kobusm/gecko-controller/Print Schematic.pdf

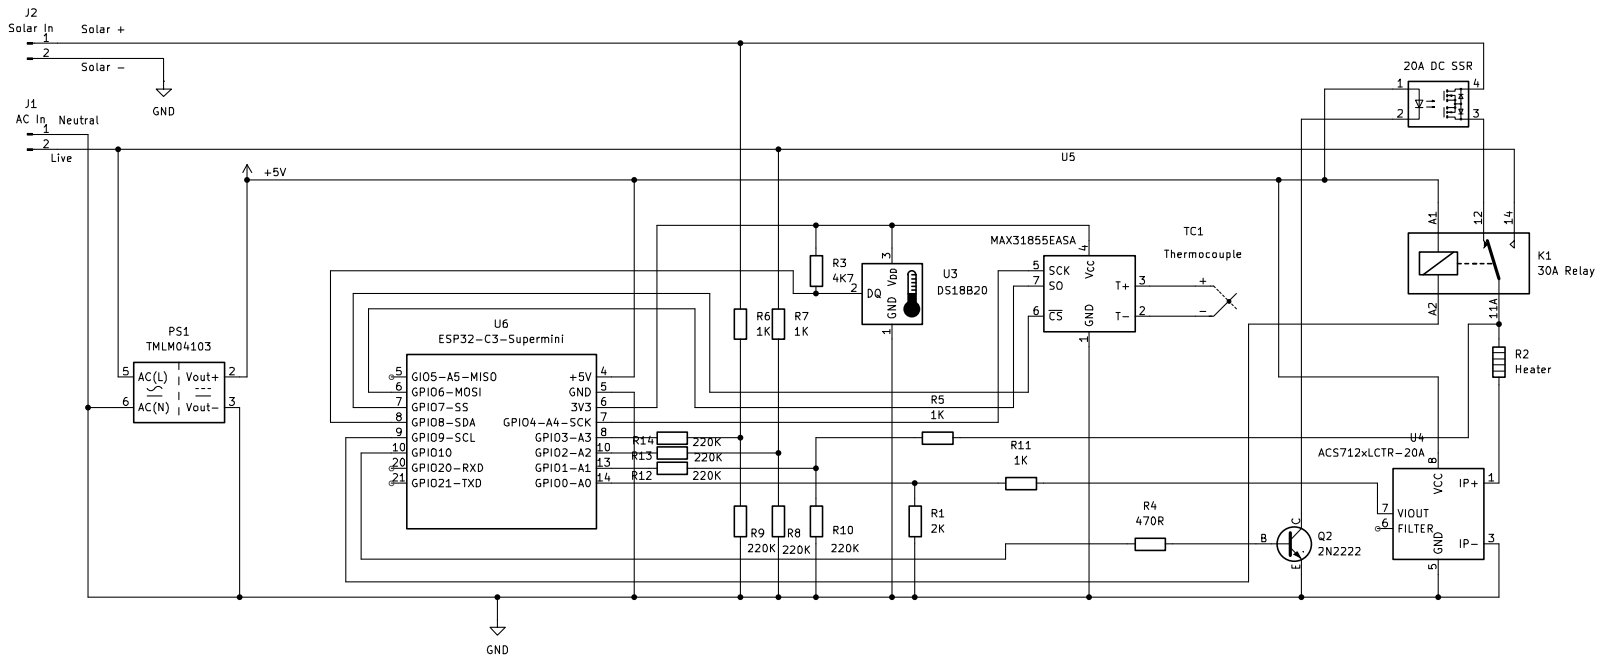
[picture p1: page 1]
