kobusm/gecko-controller/BetterGecko.pdf

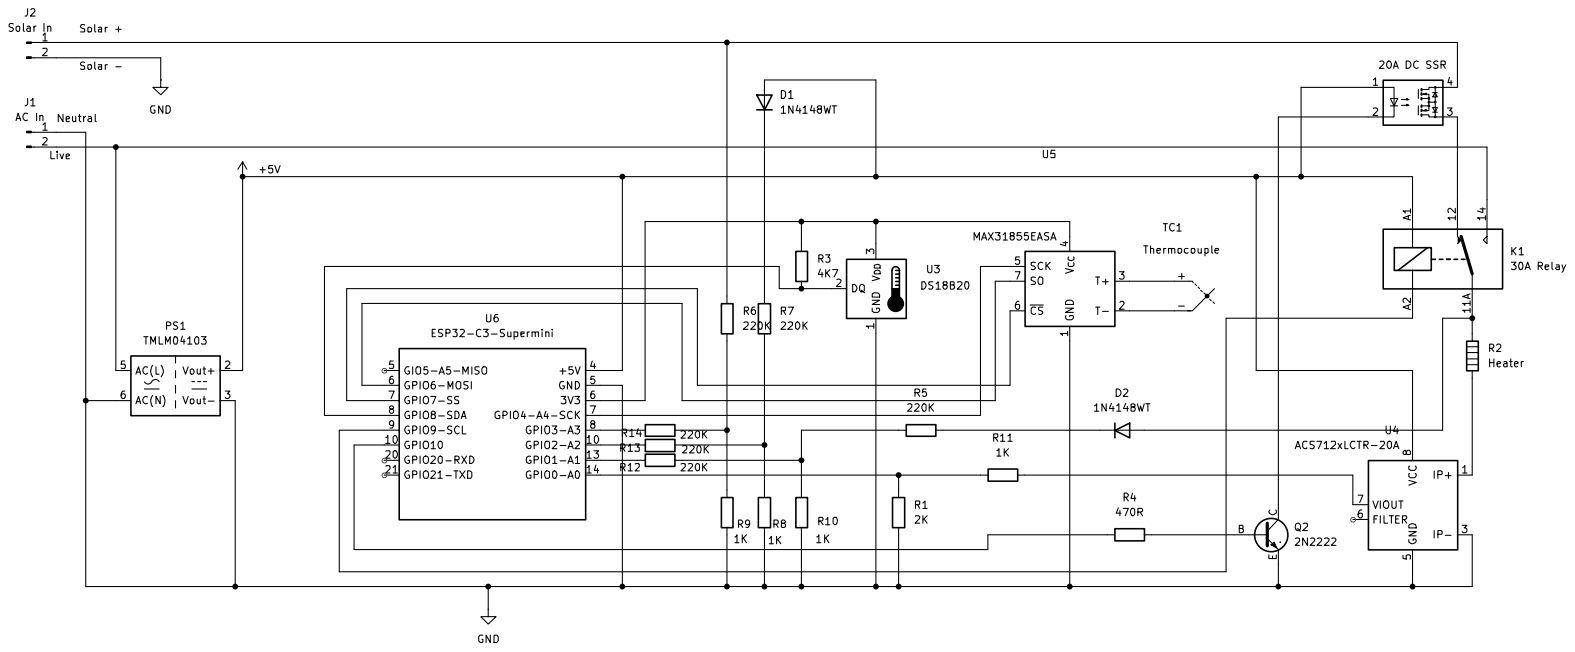
[picture p2: page 1]
