kobusm/gecko-controller/BetterGecko.kicad_sch

## KiCad design BetterGecko.kicad_sch (2026-05-28)

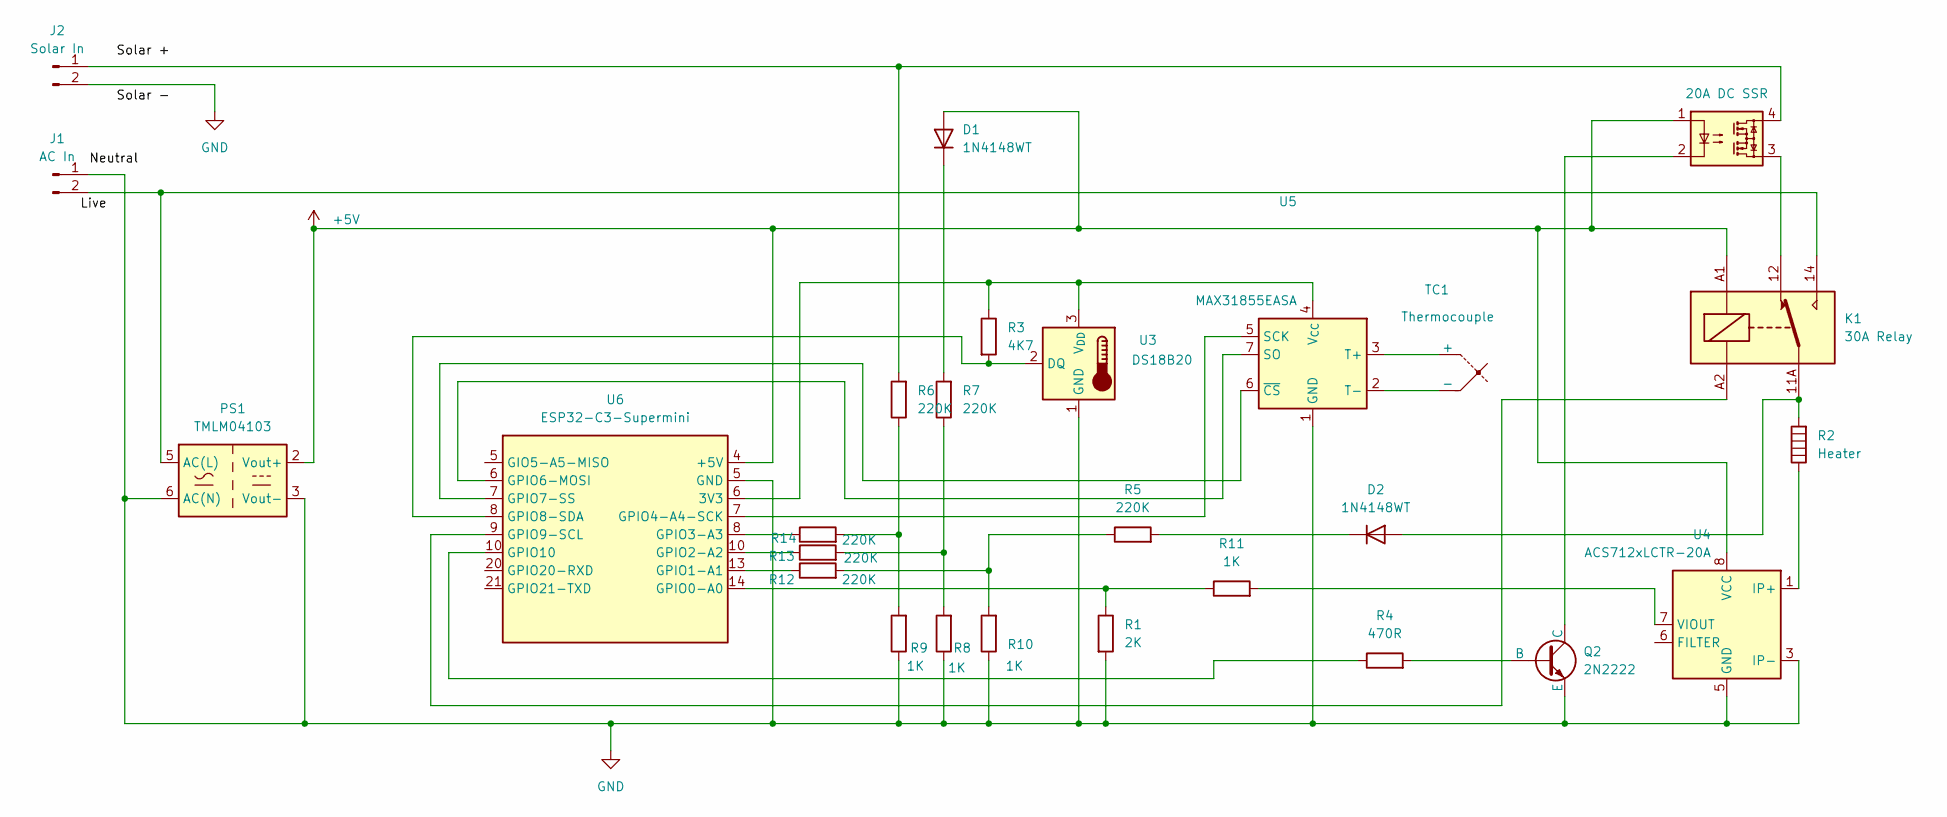
[picture p3: schematic BetterGecko.kicad_sch]

Parts:
D1, D2: 1N4148WT; D_SOD-523
J1: AC In
J2: Solar In
K1: 30A Relay; Relay_SPDT_RAYEX-L90
PS1: TMLM04103; Converter_ACDC_TRACO_TMLM-04_THT
Q2: 2N2222
R1: 2K
R2: Heater
R3: 4K7
R4: 470R
R5, R6, R7, R12, R13, R14: 220K
R8, R9, R10, R11: 1K
TC1: Thermocouple
U2: 20A DC SSR; SO-4_4.4x4.3mm_P2.54mm
U3: DS18B20; TO-92_Inline
U4: ACS712xLCTR-20A; SOIC-8_3.9x4.9mm_P1.27mm
U5: MAX31855EASA; SOIC-8_3.9x4.9mm_P1.27mm
U6: ESP32-C3-Supermini

Connections:
+5V: D1.2 (A), K1.A1, PS1.2 (Vout+), U2.1, U4.8 (VCC), U6.4 (+5V)
GND: J1.1, J2.2, PS1.3 (Vout-), PS1.6 (AC(N)), Q2.3 (E), R1.2, R8.1, R9.1, R10.1, U3.1 (GND), U4.3 (IP-), U4.4 (IP-), U4.5 (GND), U5.1 (GND), U6.5 (GIO5-A5-MISO)
unnamed: D1.1 (K), R7.2
unnamed: D2.1 (K), R5.2
unnamed: D2.2 (A), K1.11A, K1.11B, R2.2
unnamed: J1.2, K1.14, PS1.5 (AC(L))
unnamed: J2.1, R6.2, U2.4
unnamed: K1.12, U2.3
unnamed: K1.A2, U6.9 (GPIO9-SCL)
unnamed: Q2.1 (C), U2.2
unnamed: Q2.2 (B), R4.2
unnamed: R1.1, R11.1, U6.14 (GPIO0-A0)
unnamed: R2.1, U4.1 (IP+), U4.2 (IP+)
unnamed: R3.1, U3.3 (V_{DD}), U5.4 (V_{CC}), U6.6 (GPIO6-MOSI)
unnamed: R3.2, U3.2 (DQ), U6.8 (GPIO8-SDA)
unnamed: R4.1, U6.10 (GPIO10)
unnamed: R5.1, R10.2, R12.2
unnamed: R11.2, U4.7 (VIOUT)
unnamed: R12.1, U6.13 (GPIO1-A1)
unnamed: R13.1, U6.10 (GPIO10)
unnamed: R7.1, R8.2, R13.2
unnamed: R14.1, U6.8 (GPIO8-SDA)
unnamed: R6.1, R9.2, R14.2
unnamed: TC1.1 (+), U5.3 (T+)
unnamed: TC1.2 (-), U5.2 (T-)
unnamed: U5.5 (SCK), U6.7 (GPIO7-SS)
unnamed: U5.6 (~CS), U6.7 (GPIO7-SS)
unnamed: U5.7 (SO), U6.6 (GPIO6-MOSI)
