kobusm/gecko-controller/sensors.cpp

#include "sensors.h"
#include "config.h"

#include <OneWire.h>
#include <DallasTemperature.h>

// ── Hardware objects ──────────────────────────────────────────────────────────
static OneWire           oneWire(PIN_DS18B20);
static DallasTemperature ds18b20(&oneWire);

// Zero-current offset measured at startup (mV). Initialised from CURRENT_ZERO_MV
// then refined by sensorsBegin() with no load attached.
static int g_currentZeroMv = CURRENT_ZERO_MV;

// ── Helpers ───────────────────────────────────────────────────────────────────

// Read RMS of a centred AC signal from an ADC pin.
// Subtracts the DC midpoint (measured at startup with no load) then computes
// sqrt( mean( sample² ) ) over RMS_SAMPLES.
// zeroMv  — ADC millivolts at zero-signal (supply midpoint for current, or
//           half-wave midpoint for voltage divider with DC offset).
static float readRMS_mV(uint8_t pin, int zeroMv) {
  double sumSq = 0.0;
  for (int i = 0; i < RMS_SAMPLES; i++) {
    int mv = (int)analogReadMilliVolts(pin) - zeroMv;
    sumSq += (double)mv * mv;
    delayMicroseconds(250);   // ~4 kHz sample rate
  }
  return (float)sqrt(sumSq / RMS_SAMPLES);   // RMS in mV (re-zeroed)
}

// Read a DC voltage pin (multiple samples, averaged).
static float readDC_mV(uint8_t pin, uint8_t samples = 16) {
  uint32_t sum = 0;
  for (uint8_t i = 0; i < samples; i++) {
    sum += analogReadMilliVolts(pin);
    delayMicroseconds(100);
  }
  return (float)sum / samples;
}

// ── Public API ────────────────────────────────────────────────────────────────

void sensorsBegin() {
  // Set all ADC pins to 11 dB attenuation (0–3.3 V range)
  analogSetPinAttenuation(PIN_ACS712,     ADC_ATTENDB_MAX);
  analogSetPinAttenuation(PIN_PV_VOLTAGE, ADC_ATTENDB_MAX);
  analogSetPinAttenuation(PIN_AC_VOLTAGE, ADC_ATTENDB_MAX);
  analogSetPinAttenuation(PIN_ELEM_VOLT,  ADC_ATTENDB_MAX);

  ds18b20.begin();
  ds18b20.setResolution(12);          // 12-bit, ~750 ms conversion
  ds18b20.setWaitForConversion(false);// non-blocking; first result after ~1 s
  ds18b20.requestTemperatures();      // kick off first conversion

  // ── ACS712 zero-current calibration ─────────────────────────────────────
  // Average 10 readings at startup (element must be disconnected / no load).
  // Replaces the compile-time CURRENT_ZERO_MV constant.
  uint32_t sum = 0;
  for (int i = 0; i < 10; i++) {
    sum += analogReadMilliVolts(PIN_ACS712);
    delay(10);
  }
  g_currentZeroMv = (int)(sum / 10);
  Serial.printf("[sensors] ACS712 zero offset = %d mV  (config default = %d mV)\n",
                g_currentZeroMv, CURRENT_ZERO_MV);
  Serial.flush();

  Serial.println("[sensors] Initialised");
}

void sensorsRead(SensorData &s) {

  // ── DS18B20 water temperature ────────────────────────────────────────────
  s.waterTempC = ds18b20.getTempCByIndex(0);
  if (s.waterTempC == DEVICE_DISCONNECTED_C) {
    s.waterTempC = NAN;
    Serial.println("[sensors] DS18B20 disconnected");
  }
  ds18b20.requestTemperatures();    // start next conversion (ready in ~1 s)

  // ── PV string voltage (DC) ───────────────────────────────────────────────
  s.pvRawMv    = readDC_mV(PIN_PV_VOLTAGE);
  s.pvVoltageV = s.pvRawMv * PV_SCALE_V_PER_MV;

  // ── AC mains voltage (RMS) ───────────────────────────────────────────────
  // D1 (1N4148WT) half-wave rectifier passes positive half-cycles only.
  // AC_SCALE_V_PER_MV is empirically corrected; see config.h for derivation.
  s.acRawMv    = readRMS_mV(PIN_AC_VOLTAGE, 0);
  s.acVoltageV = s.acRawMv * AC_SCALE_V_PER_MV;

  // ── Element voltage ──────────────────────────────────────────────────────
  // D2 (1N4148WT) half-wave rectifier — same circuit as AC mains.
  // Note: only meaningful in AC mode; PV-mode power uses pvVoltageV instead.
  s.elemRawMv    = readRMS_mV(PIN_ELEM_VOLT, 0);
  s.elemVoltageV = s.elemRawMv * ELEM_SCALE_V_PER_MV;

  // ── ACS712-20A current ───────────────────────────────────────────────────
  s.currentRawMv = readRMS_mV(PIN_ACS712, g_currentZeroMv);
  s.currentA     = s.currentRawMv / CURRENT_SENS_MV_A;
  if (s.currentA < 0.0f) s.currentA = 0.0f;   // clamp noise below zero

  // ── Calculated power (base; BetterGecko.ino overrides for PV mode) ───────
  s.powerW = s.elemVoltageV * s.currentA;
}

float bestTempC(const SensorData &s) {
  return s.waterTempC;   // DS18B20 only; returns NAN if disconnected
}
