kobusm/gecko-controller/(commit log)

2026-05-28 Initial commit — BetterGecko solar + AC water heater controller
    Firmware (ESP32-C3):
    - Arduino sketch with DS18B20, ACS712, voltage ADC sensors
    - PV-only / AC-only / PV+AC control modes with timer windows
    - LEDC PWM for SSR, relay for AC switching
    - AWS API telemetry upload and settings sync
    Server (AWS SAM / Lambda / DynamoDB):
    - Telemetry ingest, device state, energy tracking
    - Settings with timer slots, one-shot reset command
    Web dashboard (Cloudflare Pages + Functions):
    - Dark theme single-page app: status, energy, 24h chart, settings
    - Cloudflare Worker proxy keeps API key server-side
    [BetterGecko.kicad_sch]
2026-05-28 Fix DynamoDB reserved keyword error in history query
    'current' is a DynamoDB reserved keyword — aliased it with
    ExpressionAttributeNames (#cur) in the ProjectionExpression
    so GET /history returns data instead of an error.
2026-05-28 Fix AC voltage scale and power calculation in PV mode
    AC_SCALE_V_PER_MV: 0.3126 → 0.0806 (empirical — ESP32-C3 SuperMini ADC
    reads ~3.88× higher than theoretical on this silicon; trim against a meter).
    Power: in PV_ON state use pvVoltageV × currentA instead of elemVoltageV ×
    currentA. The element voltage sensor uses a half-wave AC formula (with D2
    diode) which gives √2× error for the DC solar input; pvVoltageV uses a plain
    DC divider and reads correctly.
    Serial debug line now includes elem voltage and current for calibration.
    [BetterGecko.ino, config.h]
2026-05-30 Add raw ADC mV readings to SensorData and serial loop print
    Stores pvRawMv, acRawMv, elemRawMv, currentRawMv alongside the scaled
    values in SensorData (no extra ADC reads — reuses existing intermediate
    variables in sensorsRead).
    Loop print now shows: PV=90V(407mV) AC=230V(2854mV) etc.
    Use the raw mV value with a calibrated meter to trim the scale factors:
    new_scale = old_scale × (meter_V / displayed_V)
2026-05-30 Raw ADC fields: switch from mV floats to 0-4095 uint16_t counts
    readRMS_mV / readDC_mV now accept an optional uint16_t* rawOut param.
    Both the calibrated mV value (analogReadMilliVolts) and the raw count
    (analogRead) are gathered in the same sample loop — no extra ADC reads.
    SensorData raw fields renamed:
    pvRawMv / acRawMv / elemRawMv / currentRawMv →
    pvRaw / acRaw / elemRaw / currentRaw (uint16_t, 0-4095)
    Loop print: PV=90V(407) AC=230V(2854) elem=... I=...
2026-05-30 Revert raw fields back to mV floats
    pvRaw/acRaw/elemRaw/currentRaw → pvRawMv/acRawMv/elemRawMv/currentRawMv (float).
    Loop prints raw voltage in mV: PV=90V(407mV) AC=230V(2854mV) ...
    [BetterGecko.ino, sensors.cpp, sensors.h]
2026-05-30 Calibrate ACS712 current sensor
    Measured zero-current values:
    VIOUT = 2560 mV, GPIO0 = 1680 mV
    Divider is 1K (series) + 2K (pull-down), ratio = 2/3 = 0.6563.
    Corrects previous assumption of 1K+1K (ratio 0.5).
    CURRENT_ZERO_MV: 1250 → 1680 (measured GPIO0 at no load)
    CURRENT_SENS_MV_A: 50.0 → 65.625 (100 mV/A × 2/3 divider ratio)
    [config.h]
2026-05-30 Remove MAX31855, move ACS712 to GPIO5 (A5)
    - Delete all MAX31855 includes, hardware object, sensorsBegin init,
    sensorsRead block, and tcTempC/tcFault fields from SensorData
    - Remove PIN_MAX_SCK/CS/MISO defines (freed GPIO4/7/5)
    - PIN_ACS712: 0 → 5 (GPIO5-A5), update comment to match
    - bestTempC() simplified: returns waterTempC directly (DS18B20 only)
2026-05-30 Move ACS712 from GPIO5 to GPIO4 (ADC1_CH4)
    GPIO5 is ADC2 on ESP32-C3, which is unsupported by the Arduino
    analogRead/analogReadMilliVolts API — causes adc_oneshot unit error.
    GPIO4 is ADC1_CH4 and was freed when MAX31855 was removed.
    [config.h]
2026-06-01 Auto-calibrate ACS712 zero offset at startup
    sensorsBegin() now averages 10 analogReadMilliVolts samples on PIN_ACS712
    before any load is connected, and stores the result in g_currentZeroMv.
    This replaces the compile-time CURRENT_ZERO_MV constant for the running
    session, compensating for supply voltage variation and ADC offsets.
    CURRENT_ZERO_MV is kept as the compile-time default and is printed
    alongside the measured value for comparison:
    [sensors] ACS712 zero offset = 1683 mV (config default = 1680 mV)
    [sensors.cpp]
2026-06-01 Fix stale GPIO0 reference in ACS712 comment, restore measured zero to 1680
    Comment still said GPIO0 after pin was moved to GPIO4.
    CURRENT_ZERO_MV was 1700 (manual edit); restored to 1680 (measured value).
    Note added that sensorsBegin() overrides this at runtime anyway.
    [config.h]
2026-06-01 Remove stale MAX31855 library comment; flush serial after ACS712 calibration
    BetterGecko.ino: remove 'Adafruit MAX31855' from required-libraries list.
    sensors.cpp: Serial.flush() after ACS712 zero-offset print so the message
    is not dropped by the Hardware CDC buffer on ESP32-C3.
